mjhyman/nicu-halbach-hardware/Capacitor_Boards/capacitor_daughterboard/capacitor_daughterboard.kicad_pcb

## KiCad design Capacitor_Boards/capacitor_daughterboard/capacitor_daughterboard.kicad_pcb (2022-04-29)

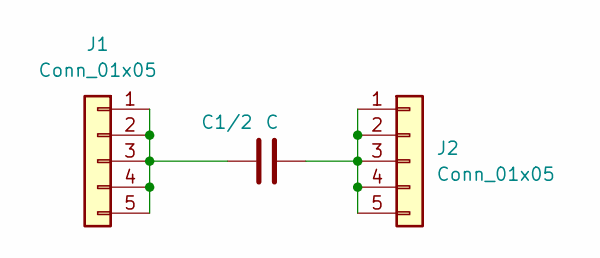
[picture p3: schematic capacitor_daughterboard.kicad_sch]

Parts:
C1/2: C; C_2225_5664Metric_Pad1.80x6.60mm_HandSolder
J1, J2: Conn_01x05; PinHeader_1x05_P2.54mm_Vertical

Connections:
unnamed: C1/2.1, J1.1, J1.2, J1.3, J1.4, J1.5
unnamed: C1/2.2, J2.1, J2.2, J2.3, J2.4, J2.5

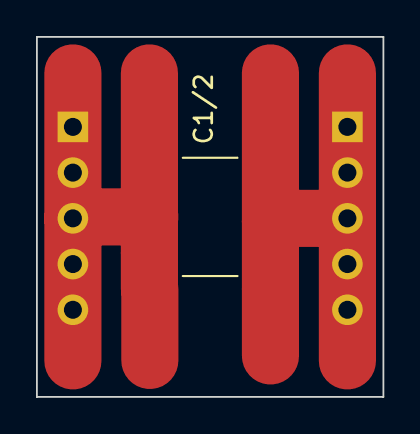
[picture p4: board capacitor_daughterboard.kicad_pcb from above]

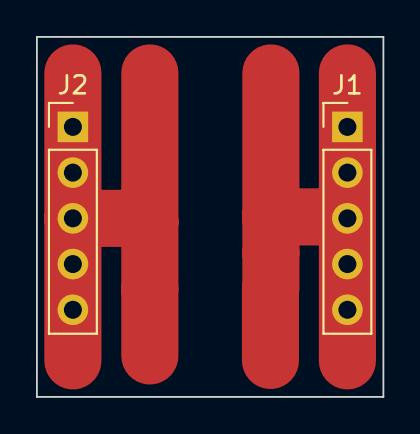
[picture p5: board capacitor_daughterboard.kicad_pcb from below]

Board: 2 copper layers, 19.2 x 20.0 mm, 3 parts (2 on the bottom side), 2 nets.
