mjhyman/nicu-halbach-hardware/Capacitor_Boards/capacitor_motherboard/cap_motherboad/cap_motherboad.kicad_pcb

## KiCad design Capacitor_Boards/capacitor_motherboard/cap_motherboad/cap_motherboad.kicad_pcb (2022-04-29)

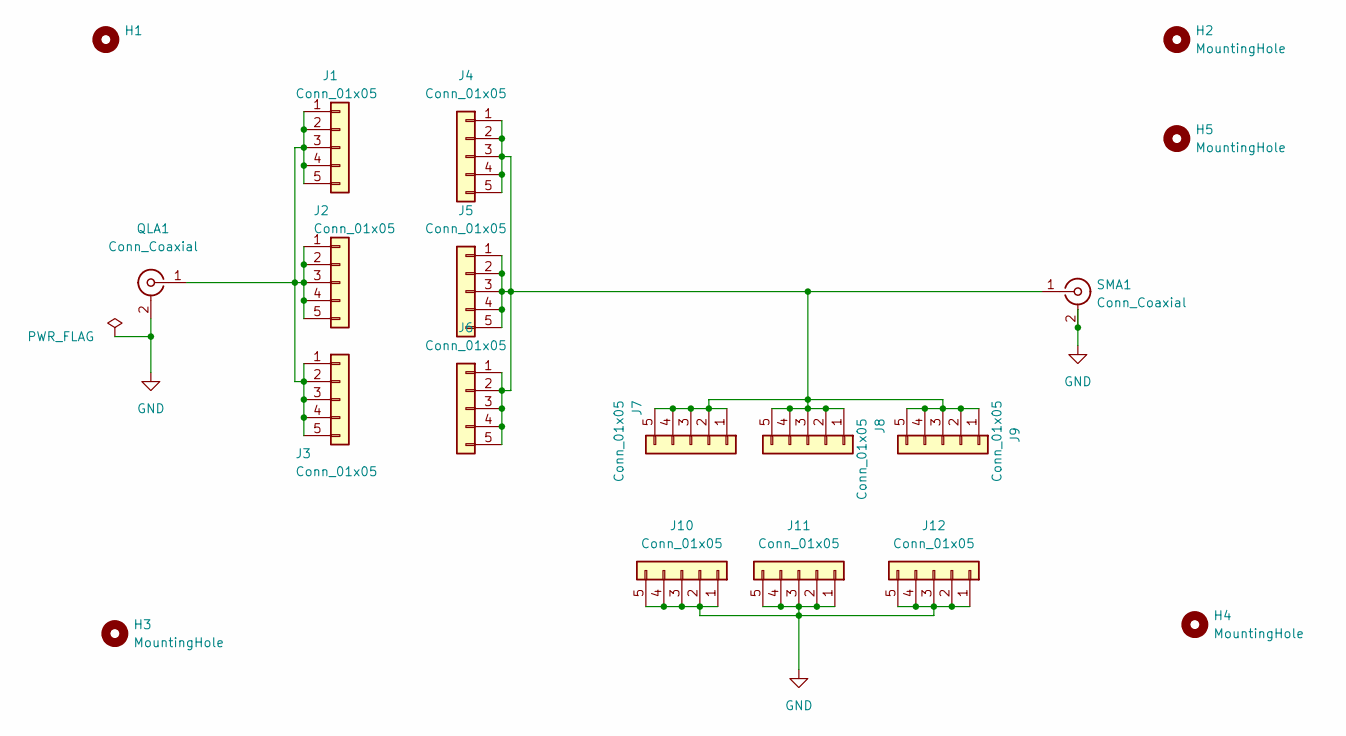
[picture p6: schematic cap_motherboad.kicad_sch, Halbach_capacitor_motherboard]

Parts:
H1: (no value)
H2, H3, H4, H5: MountingHole; MountingHole_3.2mm_M3
J1, J2, J3, J4, J5, J6, J7, J8, J9, J10, J11, J12: Conn_01x05; PinSocket_1x05_P2.54mm_Vertical
QLA1: Conn_Coaxial; SMA_Amphenol_132203-12_Horizontal
SMA1: Conn_Coaxial; SMA_Amphenol_132289_EdgeMount

Connections:
GND: J10.1, J10.2, J10.3, J10.4, J10.5, J11.1, J11.2, J11.3, J11.4, J11.5, J12.1, J12.2, J12.3, J12.4, J12.5, QLA1.2 (Ext), SMA1.2 (Ext)
unnamed: J1.1, J1.2, J1.3, J1.4, J1.5, J2.1, J2.2, J2.3, J2.4, J2.5, J3.1, J3.2, J3.3, J3.4, J3.5, QLA1.1 (In)
unnamed: J4.1, J4.2, J4.3, J4.4, J4.5, J5.1, J5.2, J5.3, J5.4, J5.5, J6.1, J6.2, J6.3, J6.4, J6.5, J7.1, J7.2, J7.3, J7.4, J7.5, J8.1, J8.2, J8.3, J8.4, J8.5, J9.1, J9.2, J9.3, J9.4, J9.5, SMA1.1 (In)

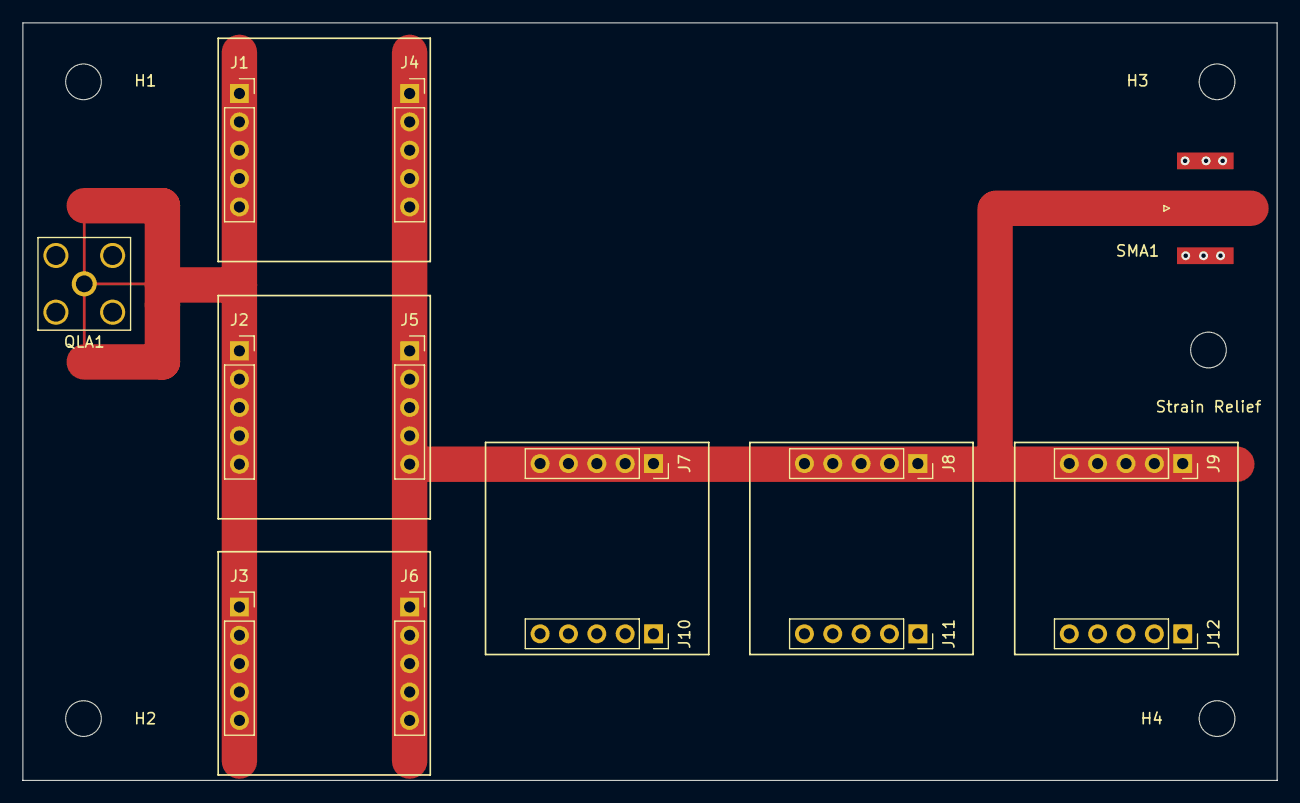
[picture p7: board cap_motherboad.kicad_pcb from above]

Board: 2 copper layers, 112.4 x 67.9 mm, 19 parts (0 on the bottom side), 3 nets.

Other parts of the board:
Strain Relief: MountingHole; MountingHole_3.2mm_M3
