mjhyman/nicu-halbach-hardware/(commit log)

2022-04-22 Adding base design with 3 caps per daughter board
    [cap_motherboad.kicad_pcb, cap_motherboad.kicad_sch, capacitor_daughterboard.kicad_pcb, capacitor_daughterboard.kicad_sch]
2022-04-22 resized capacitor daughterboard to have just 2 caps.
    [cap_motherboad.kicad_pcb, capacitor_daughterboard.kicad_pcb, capacitor_daughterboard.kicad_sch]
2022-04-22 Connected the QLA connector
    [cap_motherboad.kicad_pcb, capacitor_daughterboard.kicad_pcb]
2022-04-22 Revised layout
    [cap_motherboad.kicad_pcb]
2022-04-27 Shrunk Daughter Board
    [capacitor_daughterboard.kicad_pcb, capacitor_daughterboard.kicad_sch]
2022-04-27 Single pad for caps.
    Further reduced size of daughterboard.
    [capacitor_daughterboard.kicad_pcb, capacitor_daughterboard.kicad_sch]
2022-04-29 Finalized boards
    [cap_motherboad-B_Cu.gbr, cap_motherboad-B_Mask.gbr, cap_motherboad-B_Paste.gbr, cap_motherboad-B_Silkscreen.gbr, cap_motherboad-Edge_Cuts.gbr, cap_motherboad-F_Cu.gbr, cap_motherboad-F_Mask.gbr, cap_motherboad-F_Paste.gbr]
